cvaldess/LM20MeshNode/fab/pcbway/gerber/nrflm20-meshnode-drill_report.txt

Drill report for nrflm20-meshnode.kicad_pcb
Created on 2026-11-12T16:53:03

Copper Layer Stackup:
    =============================================================
    L1 :  F.Cu                      front
    L2 :  In1.Cu                    in1
    L3 :  In2.Cu                    in2
    L4 :  B.Cu                      back

Drill file 'nrflm20-meshnode-PTH.drl' contains
    plated through holes:
    =============================================================
    T1  0.300mm  0.0118"  (169 holes))
    T2  0.300mm  0.0118"  (5 holes))
    T3  0.600mm  0.0236"  (4 holes)  (with 4 slots)
    T4  0.900mm  0.0354"  (8 holes))
    T5  1.000mm  0.0394"  (4 holes))

    Total plated holes count 190

Drill file 'nrflm20-meshnode-NPTH.drl' contains
    unplated through holes:
    =============================================================
    T1  0.650mm  0.0256"  (2 holes))
    T2  2.200mm  0.0866"  (4 holes))

    Total unplated holes count 6
