cvaldess/LM20MeshNode/fab/pcbway/nrflm20-meshnode-BOM-PCBWay.csv

Designator | Qty | Manufacturer | Mfg Part # | Description/Value | Package/Footprint | LCSC Part #
BZ501 | 1 | Huayu | HYG-5020A | HYG-5020A | easyeda2kicad:BUZ-SMD_3P-L5.0-W5.0-P3.50-BL | C7544810
C101,C102,C204,C502 | 4 | Samsung | CL05A105KA5NQNC | 1u 25V | Capacitor_SMD:C_0402_1005Metric | C52923
C103,C104,C105,C107,C108,C201,C202,C401 | 8 | Generic |  | 10uF 20% 10V X7R 0603 | Capacitor_SMD:C_0603_1608Metric
C106 | 1 | Samsung | CL10A225KO8NNNC | 2u2 16V | Capacitor_SMD:C_0603_1608Metric | C23630
C110,C111,C203,C302,C402,C403,C501,C503,C504 | 9 | Samsung | CL05B104KO5NNNC | 100n | Capacitor_SMD:C_0402_1005Metric | C1525
C301 | 1 | Generic |  | 22uF 20% 10V X7R 0603 | Capacitor_SMD:C_0603_1608Metric
C404 | 1 | Samsung | CL05C560JB5NNNC | 56p C0G | Capacitor_SMD:C_0402_1005Metric | C84707
D101 | 1 | onsemi | ESD5Z6.0T1G | ESD5Z6.0T1G | easyeda2kicad:SOD-523F_L1.2-W0.8-LS1.7-RD | C82323
D102 | 1 | XINGLIGHT | XL-1608UBC-06A | Blue LED | LED_SMD:LED_0603_1608Metric | C7371904
D103,D501 | 2 | XINGLIGHT | XL-1608UGC-06A | Green LED | LED_SMD:LED_0603_1608Metric | C7371903
D502 | 1 | JSMSEMI | 1N4148W | 1N4148W | Diode_SMD:D_SOD-123 | C917030
DS501 | 1 | HS | HS91L02W2C01 | HS91L02W2C01 | easyeda2kicad:OLED-TH_L38.0-W12.0_HS91L02W2C01 | C5248081
FB201 | 1 | Generic |  | 0R 0603 jumper | Resistor_SMD:R_0603_1608Metric
J101 | 1 | Kinghelm | KH-TYPE-C-16P | KH-TYPE-C-16P | easyeda2kicad:USB-C-SMD_KH-TYPE-C-16P | C709357
J102 | 1 | JST | S2B-PH-SM4-TB(LF)(SN) | S2B-PH-SM4-TB | Connector_JST:JST_PH_S2B-PH-SM4-TB_1x02-1MP_P2.00mm_Horizontal | C295747
J201 | 1 | HANXIA | HX PZ1.27-2x5P TP | SWD 2x5 1.27 | Connector_PinHeader_1.27mm:PinHeader_2x05_P1.27mm_Vertical_SMD | C41376037
J301 | 1 | BAT WIRELESS | BWU.FL-IPEX1 | U.FL LoRa | easyeda2kicad:IPEX-SMD_BWIPX-1-001E | C5137195
J401 | 1 | BAT WIRELESS | BWU.FL-IPEX1 | U.FL GNSS | easyeda2kicad:IPEX-SMD_BWIPX-1-001E | C5137195
J501 | 1 | BOOMELE | 1.0T-4P | Qwiic 1.0T-4P | meshnode:BOOMELE_1.0T-4P_1x04-1MP_P1.00mm_Horizontal | C970137
L101,L102 | 2 | APV | APH201610C2R2MP01 | 2u2 | Inductor_SMD:L_Changjiang_FTC201610S | C42455301
L401 | 1 | Murata | LQG15HS82NJ02D | 82nH (active GNSS antenna bias) | Inductor_SMD:L_0402_1005Metric | C98002
Q501 | 1 | HT (Jin Yu) | BSS138 | BSS138 | Package_TO_SOT_SMD:SOT-23 | C27140738
R101,R301,R304 | 3 | Yageo | RC0402FR-070RL | 0R | Resistor_SMD:R_0402_1005Metric | C106231
R102 | 1 | Yageo | RC0402JR-07330KL | 330k 5% | Resistor_SMD:R_0402_1005Metric | C137882
R103,R104 | 2 | Yageo | RC0402FR-071ML | 1M | Resistor_SMD:R_0402_1005Metric | C138033
R303,R505 | 2 | Yageo | RC0402FR-07100KL | 100k | Resistor_SMD:R_0402_1005Metric | C60491
R401,R402,R403 | 3 | UNI-ROYAL | 0402WGF1001TCE | 1k | Resistor_SMD:R_0402_1005Metric | C11702
R501,R502 | 2 | Yageo | RC0402FR-074K7L | 4k7 | Resistor_SMD:R_0402_1005Metric | C105871
R503 | 1 | UNI-ROYAL | 0402WGF4700TCE | 470R | Resistor_SMD:R_0402_1005Metric | C25117
R504 | 1 | UNI-ROYAL | 0402WGF2200TCE | 220R | Resistor_SMD:R_0402_1005Metric | C25091
R506,R507 | 2 | Generic |  | 10R 5% 0603 | Resistor_SMD:R_0603_1608Metric
RT101 | 1 | Murata | NCP15XH103F0SRC | 10k B3380 | Resistor_SMD:R_0402_1005Metric | C91636
SW101,SW501,SW502,SW503 | 4 | Hanxia | HX TS35CA 160gf | HX TS35CA 160gf | easyeda2kicad:KEY-SMD_HX-TS35CA-250GF | C25168837
U101 | 1 | Nordic Semiconductor | nPM1300-QEAA | nPM1300-QEAA | meshnode:nPM1300-QFN32-EP3.5 | C7501206
U102 | 1 | DOWO | TPD4E05U06DQAR | TPD4E05U06DQAR | easyeda2kicad:DFN2510-10_L2.5-W1.0-P0.50-BL | C22390021
U201 | 1 | Minew | ME54BS13 (nRF54LM20A) | ME54BS13 | meshnode:ME54BS13
U301 | 1 | Ebyte | E22-900MM22S | E22-900MM22S | meshnode:E22-xxxMM22S
U401 | 1 | Ebyte | E108-GN04S | E108-GN04S | meshnode:E108-GN04S
U501 | 1 | Nyfea | SHT41-P-NF | SHT41-P-NF | easyeda2kicad:DFN-4_L1.5-W1.5-SHT41-AD1B-R2 | C55108905
U502 | 1 | STMicroelectronics | LSM6DS3TR-C | LSM6DS3TR-C | easyeda2kicad:LGA-14_L3.0-W2.5-P0.50-TL | C967633
