cvaldess/LM20MeshNode/nrflm20-meshnode.kicad_pcb

## KiCad design nrflm20-meshnode.kicad_pcb (2026-11-13)

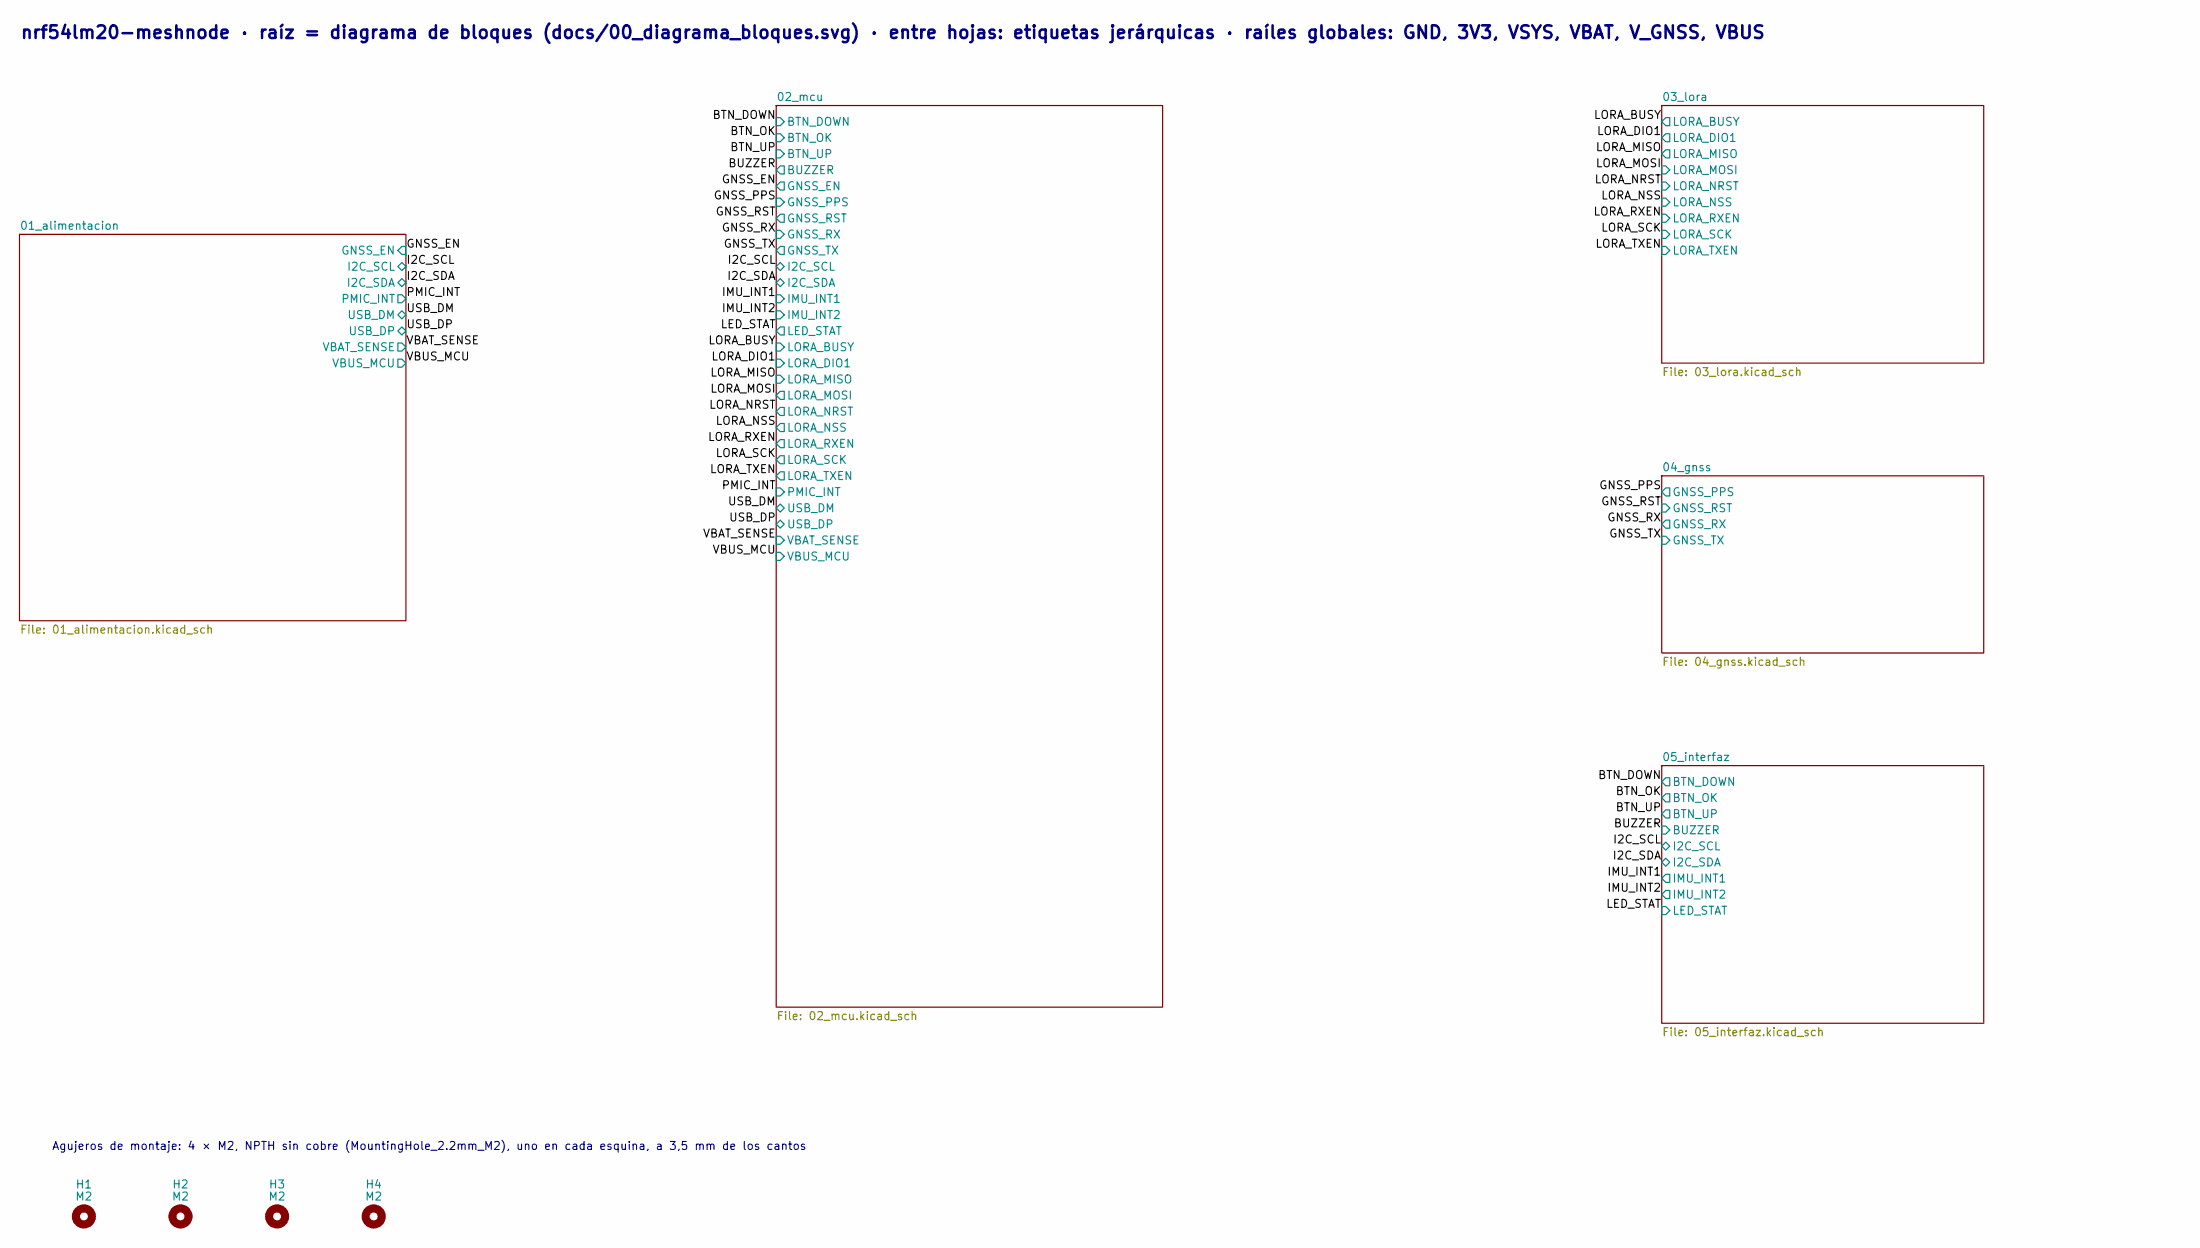
[picture p4: schematic nrflm20-meshnode.kicad_sch, nRF54LM20-MeshNode]

Parts:
H1, H2, H3, H4: M2; MountingHole_2.2mm_M2

Notes on the sheet:
nrf54lm20-meshnode · raíz = diagrama de bloques (docs/00_diagrama_bloques.svg) · entre hojas: etiquetas jerárquicas · raíles globales: GND, 3V3, VSYS, VBAT, V_GNSS, VBUS
Agujeros de montaje: 4 × M2, NPTH sin cobre (MountingHole_2.2mm_M2), uno en cada esquina, a 3,5 mm de los cantos

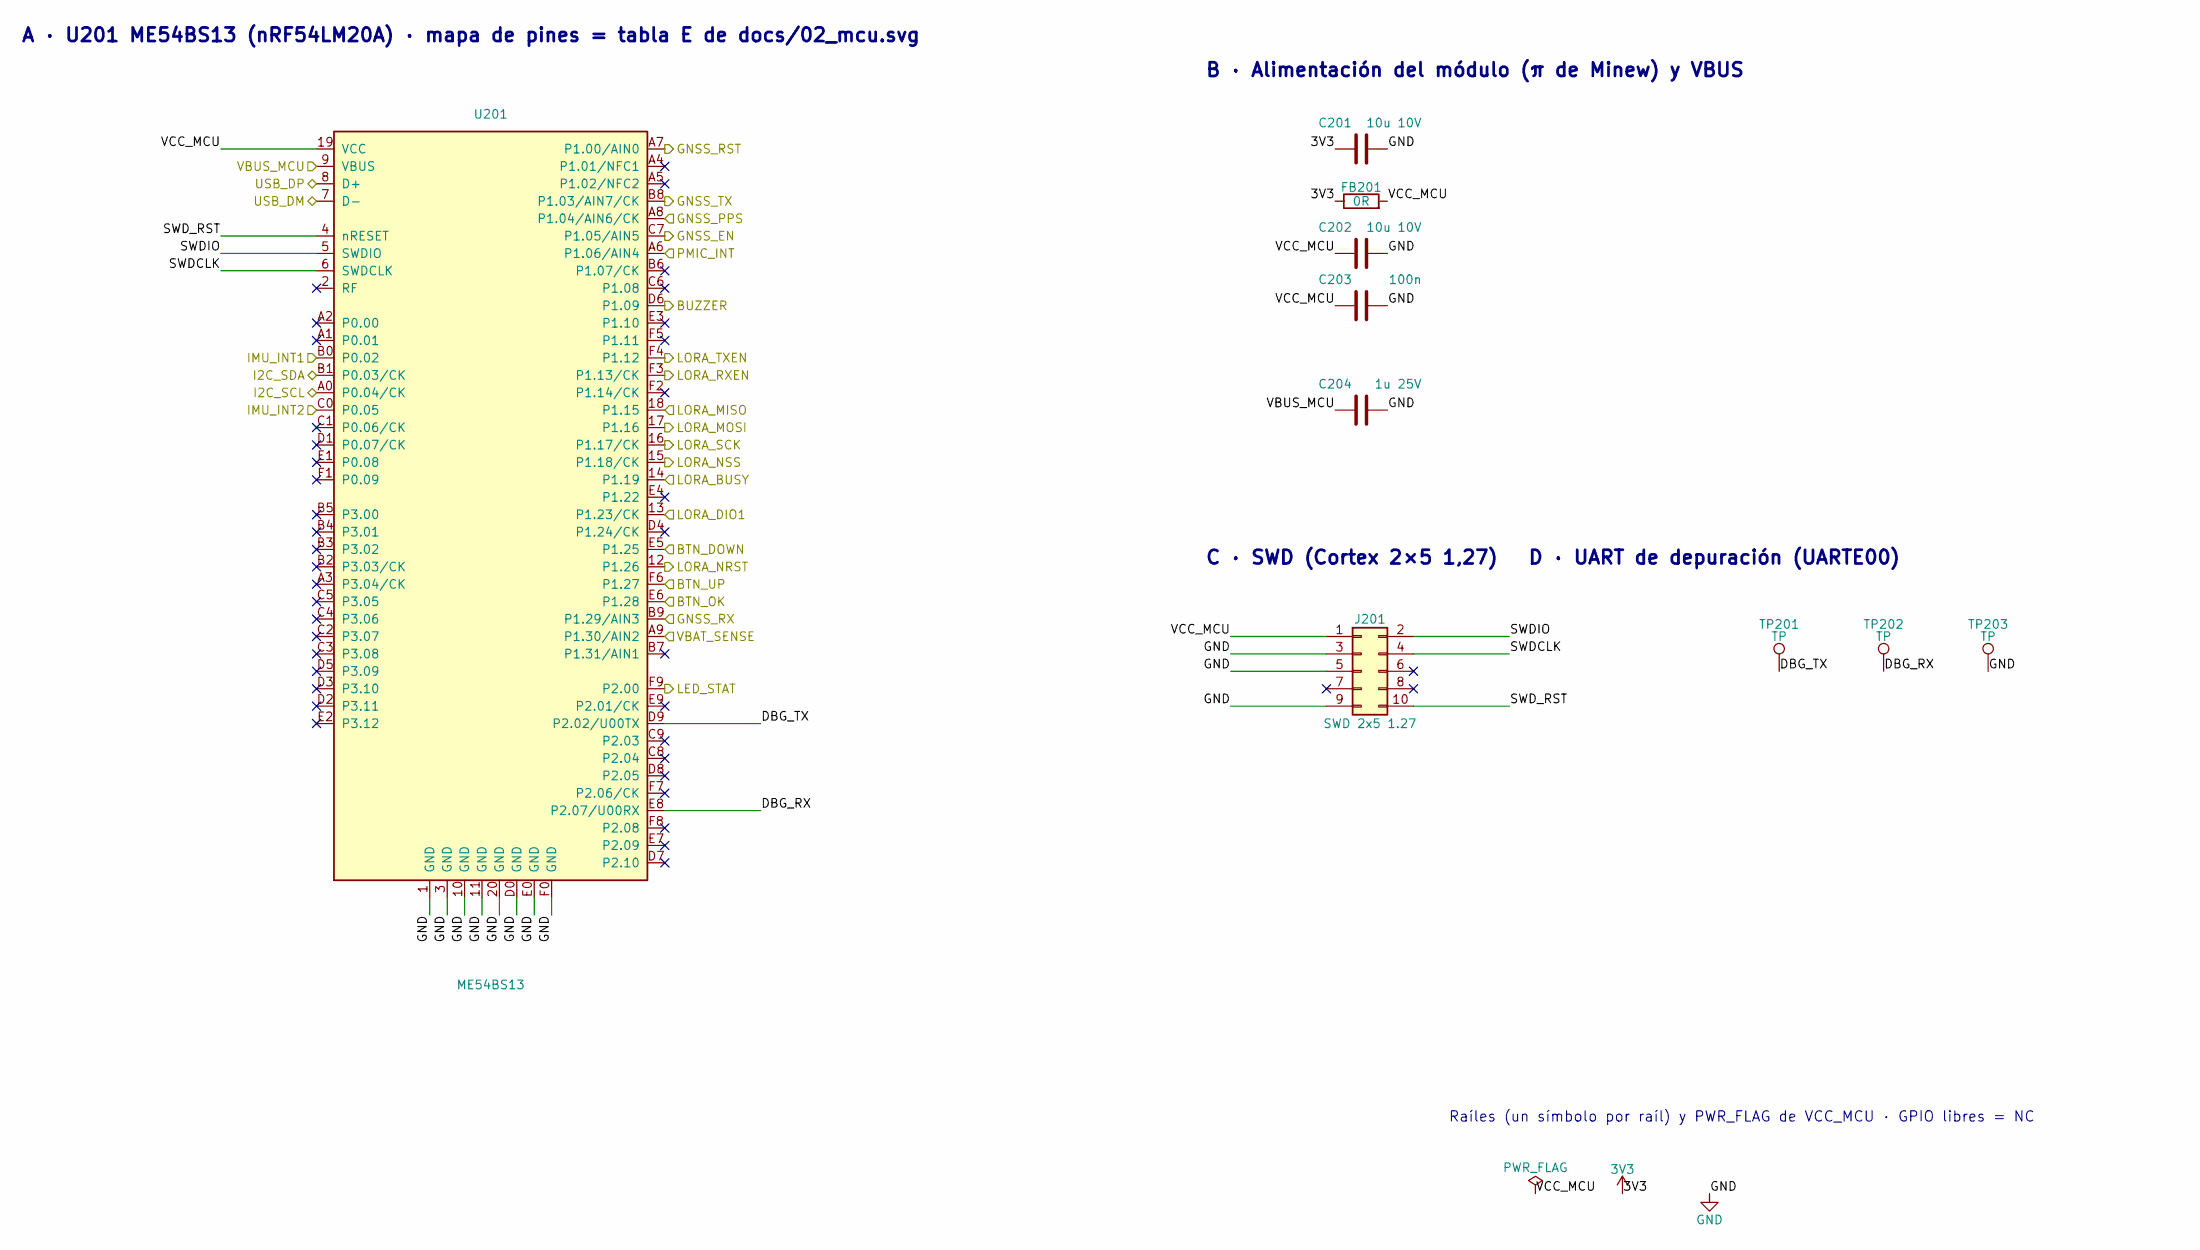
[picture p5: schematic 02_mcu.kicad_sch, nRF54LM20-MeshNode]

Parts:
C201, C202: 10u 10V; C_0603_1608Metric
C203: 100n; C_0402_1005Metric; MPN CL05B104KO5NNNC; LCSC Part C1525
C204: 1u 25V; C_0402_1005Metric; MPN CL05A105KA5NQNC; LCSC Part C52923
FB201: 0R; R_0603_1608Metric
J201: SWD 2x5 1.27; PinHeader_2x05_P1.27mm_Vertical_SMD; MPN HX PZ1.27-2x5P TP; LCSC Part C41376037
TP201, TP202, TP203: TP; TestPoint_Pad_D1.0mm
U201: ME54BS13; MPN ME54BS13 (nRF54LM20A)

Connections:
3V3: C201.1, FB201.1; also elsewhere on the board
/02_mcu/DBG_RX: TP202.1 (1_1), U201.E8 (P2.07/U00RX)
/02_mcu/DBG_TX: TP201.1 (1_1), U201.D9 (P2.02/U00TX)
/02_mcu/SWDCLK: J201.4, U201.6 (SWDCLK)
/02_mcu/SWDIO: J201.2, U201.5 (SWDIO)
/02_mcu/SWD_RST: J201.10, U201.4 (nRESET)
/02_mcu/VCC_MCU: C202.1, C203.1, FB201.2, J201.1, U201.19 (VCC)
/BTN_DOWN: U201.E5 (P1.25); also elsewhere on the board
/BTN_OK: U201.E6 (P1.28); also elsewhere on the board
/BTN_UP: U201.F6 (P1.27); also elsewhere on the board
/BUZZER: U201.D6 (P1.09); also elsewhere on the board
/GNSS_EN: U201.C7 (P1.05/AIN5); also elsewhere on the board
/GNSS_PPS: U201.A8 (P1.04/AIN6/CK); also elsewhere on the board
/GNSS_RST: U201.A7 (P1.00/AIN0); also elsewhere on the board
/GNSS_RX: U201.B9 (P1.29/AIN3); also elsewhere on the board
/GNSS_TX: U201.B8 (P1.03/AIN7/CK); also elsewhere on the board
/I2C_SCL: U201.A0 (P0.04/CK); also elsewhere on the board
/I2C_SDA: U201.B1 (P0.03/CK); also elsewhere on the board
/IMU_INT1: U201.B0 (P0.02); also elsewhere on the board
/IMU_INT2: U201.C0 (P0.05); also elsewhere on the board
/LED_STAT: U201.F9 (P2.00); also elsewhere on the board
/LORA_BUSY: U201.14 (P1.19); also elsewhere on the board
/LORA_DIO1: U201.13 (P1.23/CK); also elsewhere on the board
/LORA_MISO: U201.18 (P1.15); also elsewhere on the board
/LORA_MOSI: U201.17 (P1.16); also elsewhere on the board
/LORA_NRST: U201.12 (P1.26); also elsewhere on the board
/LORA_NSS: U201.15 (P1.18/CK); also elsewhere on the board
/LORA_RXEN: U201.F3 (P1.13/CK); also elsewhere on the board
/LORA_SCK: U201.16 (P1.17/CK); also elsewhere on the board
/LORA_TXEN: U201.F4 (P1.12); also elsewhere on the board
/PMIC_INT: U201.A6 (P1.06/AIN4); also elsewhere on the board
/USB_DM: U201.7 (D-); also elsewhere on the board
/USB_DP: U201.8 (D+); also elsewhere on the board
/VBAT_SENSE: U201.A9 (P1.30/AIN2); also elsewhere on the board
/VBUS_MCU: C204.1, U201.9 (VBUS); also elsewhere on the board
GND: C201.2, C202.2, C203.2, C204.2, J201.3, J201.5, J201.9, TP203.1 (1_1), U201.1 (GND), U201.3 (GND), U201.10 (GND), U201.11 (GND), U201.20 (GND), U201.D0 (GND), U201.E0 (GND), U201.F0 (GND); also elsewhere on the board

Notes on the sheet:
B · Alimentación del módulo (π de Minew) y VBUS
A · U201 ME54BS13 (nRF54LM20A) · mapa de pines = tabla E de docs/02_mcu.svg
C · SWD (Cortex 2×5 1,27) D · UART de depuración (UARTE00)
Raíles (un símbolo por raíl) y PWR_FLAG de VCC_MCU · GPIO libres = NC

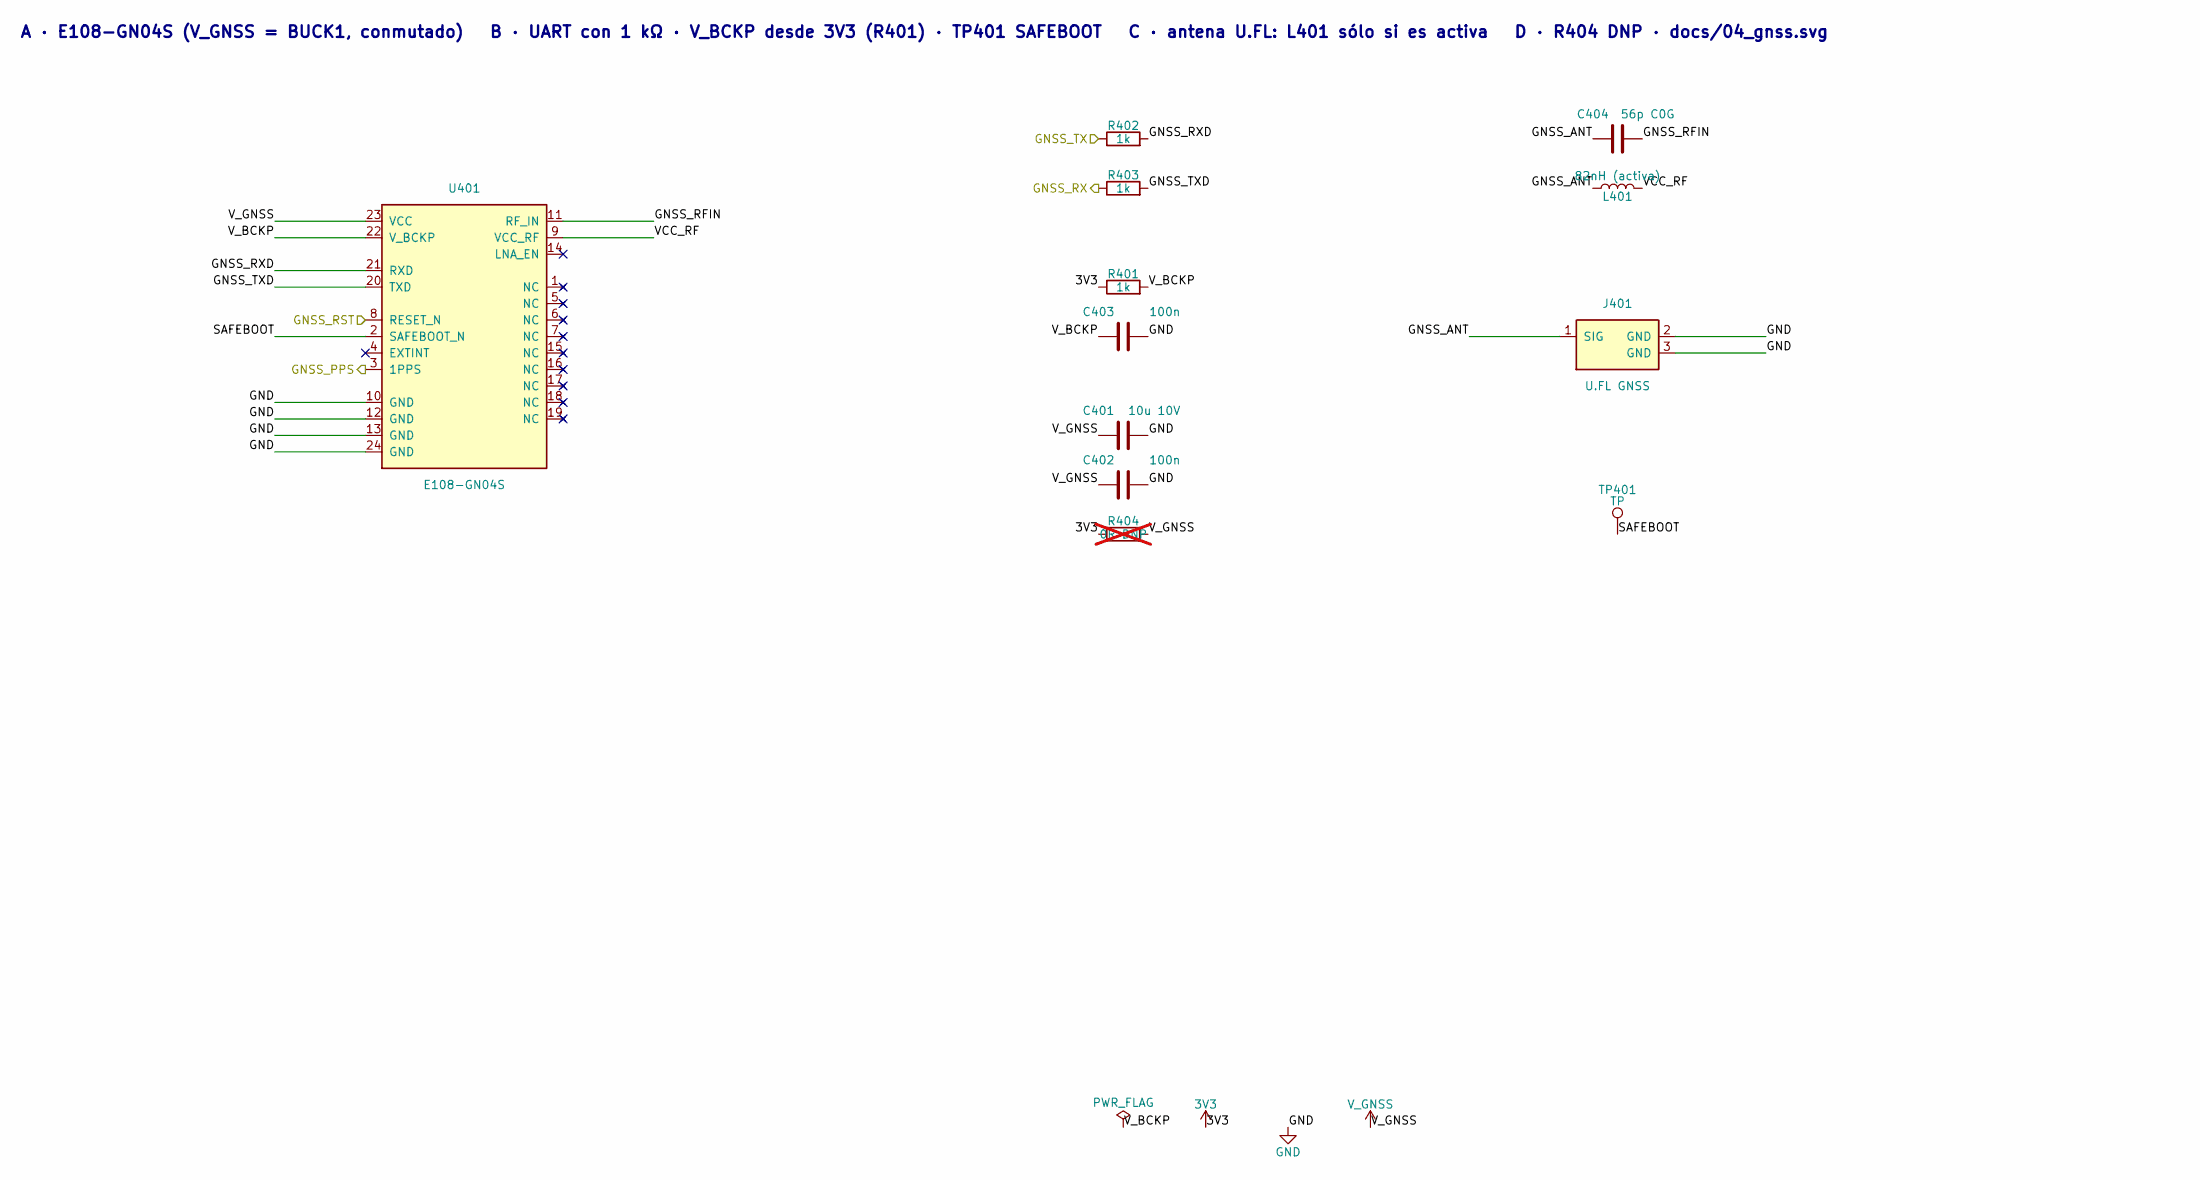
[picture p6: schematic 04_gnss.kicad_sch, nRF54LM20-MeshNode]

Parts:
C401: 10u 10V; C_0603_1608Metric
C402, C403: 100n; C_0402_1005Metric; MPN CL05B104KO5NNNC; LCSC Part C1525
C404: 56p C0G; C_0402_1005Metric; MPN CL05C560JB5NNNC; LCSC Part C84707
J401: U.FL GNSS; IPEX-SMD_BWIPX-1-001E; MPN BWU.FL-IPEX1; LCSC Part C5137195
L401: 82nH (activa); L_0402_1005Metric; MPN LQG15HS82NJ02D; LCSC Part C98002
R401, R402, R403: 1k; R_0402_1005Metric; MPN 0402WGF1001TCE; LCSC Part C11702
R404: 0R DNP; R_0402_1005Metric; MPN RC0402FR-070RL; LCSC Part C106231; not fitted
TP401: TP; TestPoint_Pad_D1.0mm
U401: E108-GN04S; MPN E108-GN04S

Connections:
3V3: R401.1, R404.1; also elsewhere on the board
/04_gnss/GNSS_ANT: C404.1, J401.1 (SIG), L401.1
/04_gnss/GNSS_RFIN: C404.2, U401.11 (RF_IN)
/04_gnss/GNSS_RXD: R402.2, U401.21 (RXD)
/04_gnss/GNSS_TXD: R403.2, U401.20 (TXD)
/04_gnss/SAFEBOOT: TP401.1 (1_1), U401.2 (SAFEBOOT_N)
/04_gnss/VCC_RF: L401.2, U401.9 (VCC_RF)
/04_gnss/V_BCKP: C403.1, R401.2, U401.22 (V_BCKP)
/GNSS_PPS: U401.3 (1PPS); also elsewhere on the board
/GNSS_RST: U401.8 (RESET_N); also elsewhere on the board
/GNSS_RX: R403.1; also elsewhere on the board
/GNSS_TX: R402.1; also elsewhere on the board
GND: C401.2, C402.2, C403.2, J401.2 (GND), J401.3 (GND), U401.10 (GND), U401.12 (GND), U401.13 (GND), U401.24 (GND); also elsewhere on the board
V_GNSS: C401.1, C402.1, R404.2, U401.23 (VCC); also elsewhere on the board

Notes on the sheet:
A · E108-GN04S (V_GNSS = BUCK1, conmutado) B · UART con 1 kΩ · V_BCKP desde 3V3 (R401) · TP401 SAFEBOOT C · antena U.FL: L401 sólo si es activa D · R404 DNP · docs/04_gnss.svg

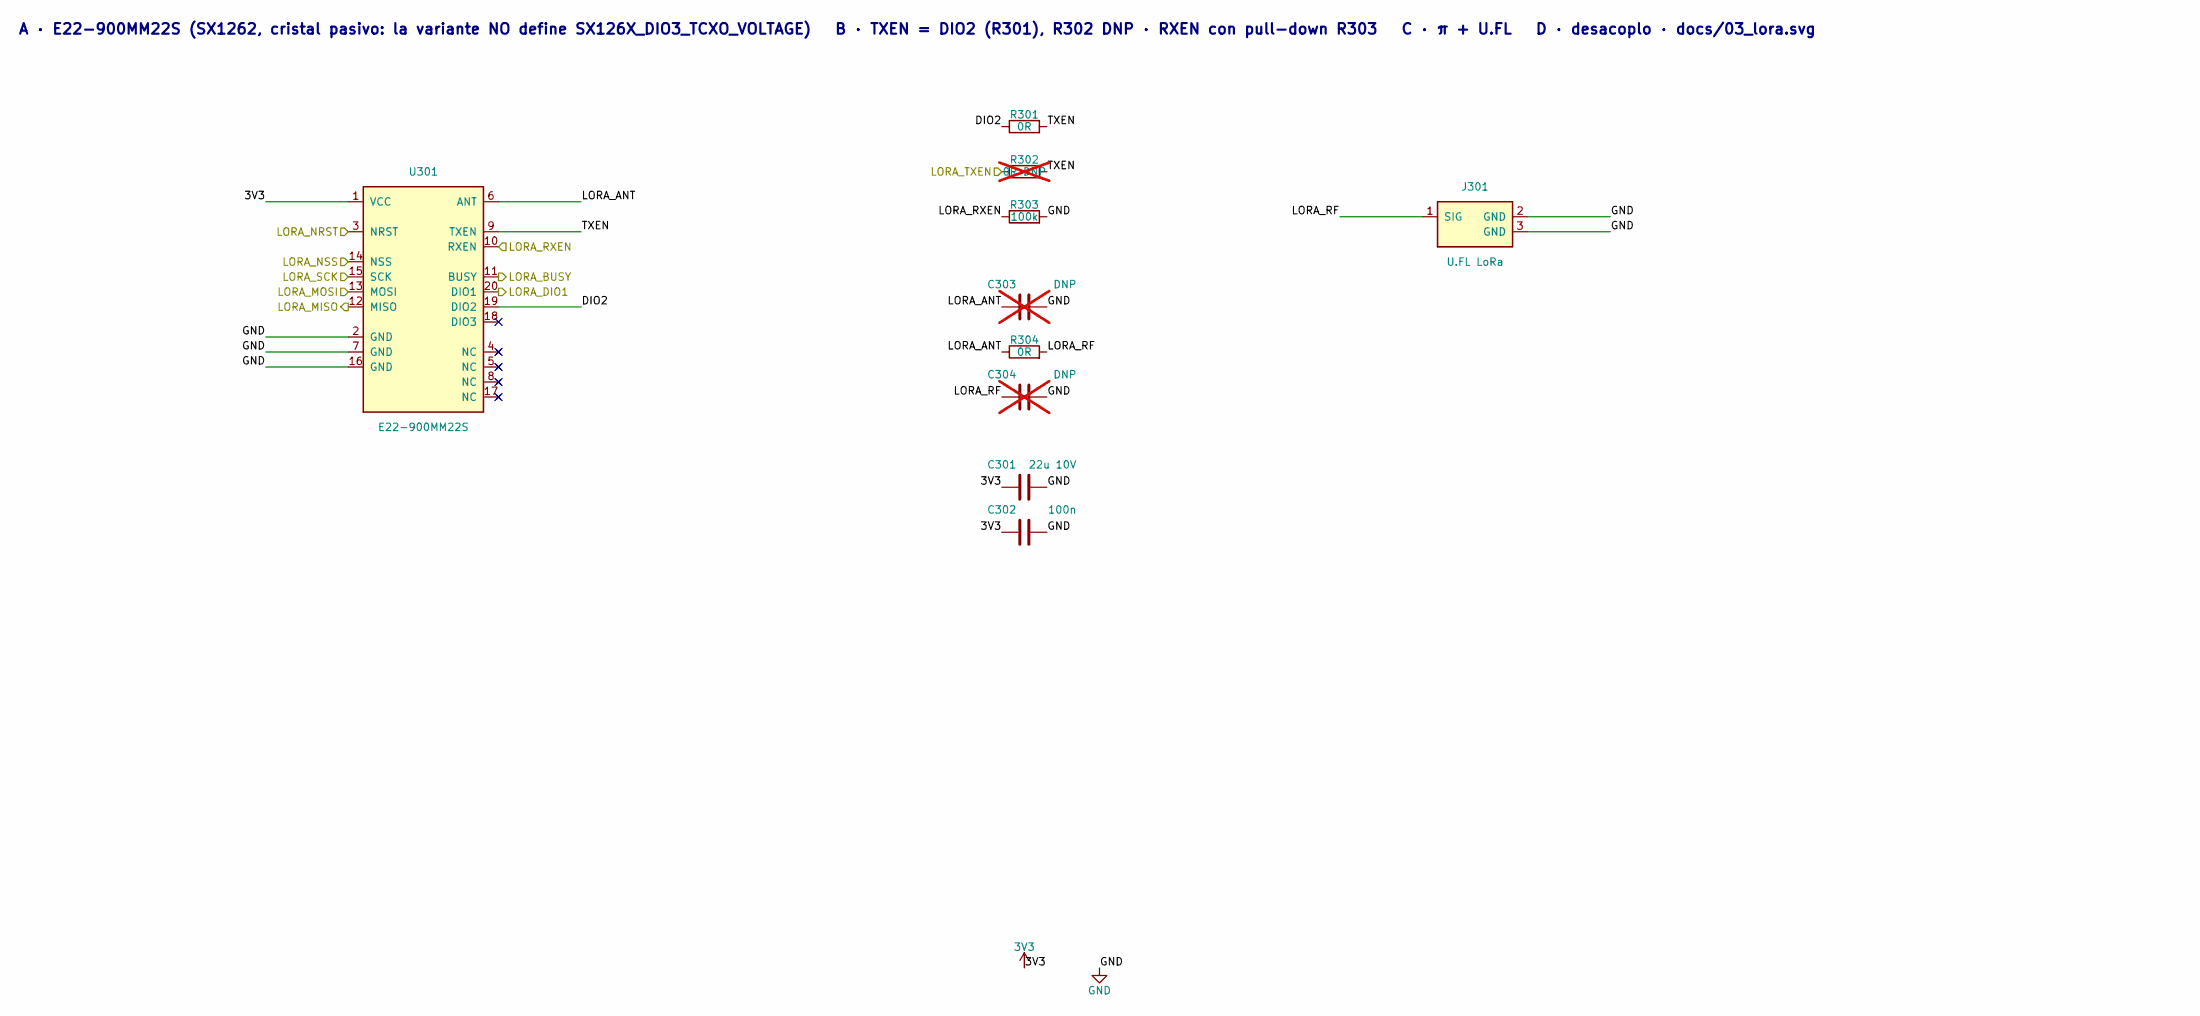
[picture p7: schematic 03_lora.kicad_sch, nRF54LM20-MeshNode]

Parts:
C301: 22u 10V; C_0603_1608Metric
C302: 100n; C_0402_1005Metric; MPN CL05B104KO5NNNC; LCSC Part C1525
C303, C304: DNP; C_0402_1005Metric; not fitted
J301: U.FL LoRa; IPEX-SMD_BWIPX-1-001E; MPN BWU.FL-IPEX1; LCSC Part C5137195
R301, R304: 0R; R_0402_1005Metric; MPN RC0402FR-070RL; LCSC Part C106231
R302: 0R DNP; R_0402_1005Metric; MPN RC0402FR-070RL; LCSC Part C106231; not fitted
R303: 100k; R_0402_1005Metric; MPN RC0402FR-07100KL; LCSC Part C60491
U301: E22-900MM22S; E22-xxxMM22S; MPN E22-900MM22S

Connections:
3V3: C301.1, C302.1, U301.1 (VCC); also elsewhere on the board
/03_lora/DIO2: R301.1, U301.19 (DIO2)
/03_lora/LORA_ANT: C303.1, R304.1, U301.6 (ANT)
/03_lora/LORA_RF: C304.1, J301.1 (SIG), R304.2
/03_lora/TXEN: R301.2, R302.2, U301.9 (TXEN)
/LORA_BUSY: U301.11 (BUSY); also elsewhere on the board
/LORA_DIO1: U301.20 (DIO1); also elsewhere on the board
/LORA_MISO: U301.12 (MISO); also elsewhere on the board
/LORA_MOSI: U301.13 (MOSI); also elsewhere on the board
/LORA_NRST: U301.3 (NRST); also elsewhere on the board
/LORA_NSS: U301.14 (NSS); also elsewhere on the board
/LORA_RXEN: R303.1, U301.10 (RXEN); also elsewhere on the board
/LORA_SCK: U301.15 (SCK); also elsewhere on the board
/LORA_TXEN: R302.1; also elsewhere on the board
GND: C301.2, C302.2, C303.2, C304.2, J301.2 (GND), J301.3 (GND), R303.2, U301.2 (GND), U301.7 (GND), U301.16 (GND); also elsewhere on the board

Notes on the sheet:
A · E22-900MM22S (SX1262, cristal pasivo: la variante NO define SX126X_DIO3_TCXO_VOLTAGE) B · TXEN = DIO2 (R301), R302 DNP · RXEN con pull-down R303 C · π + U.FL D · desacoplo · docs/03_lora.svg

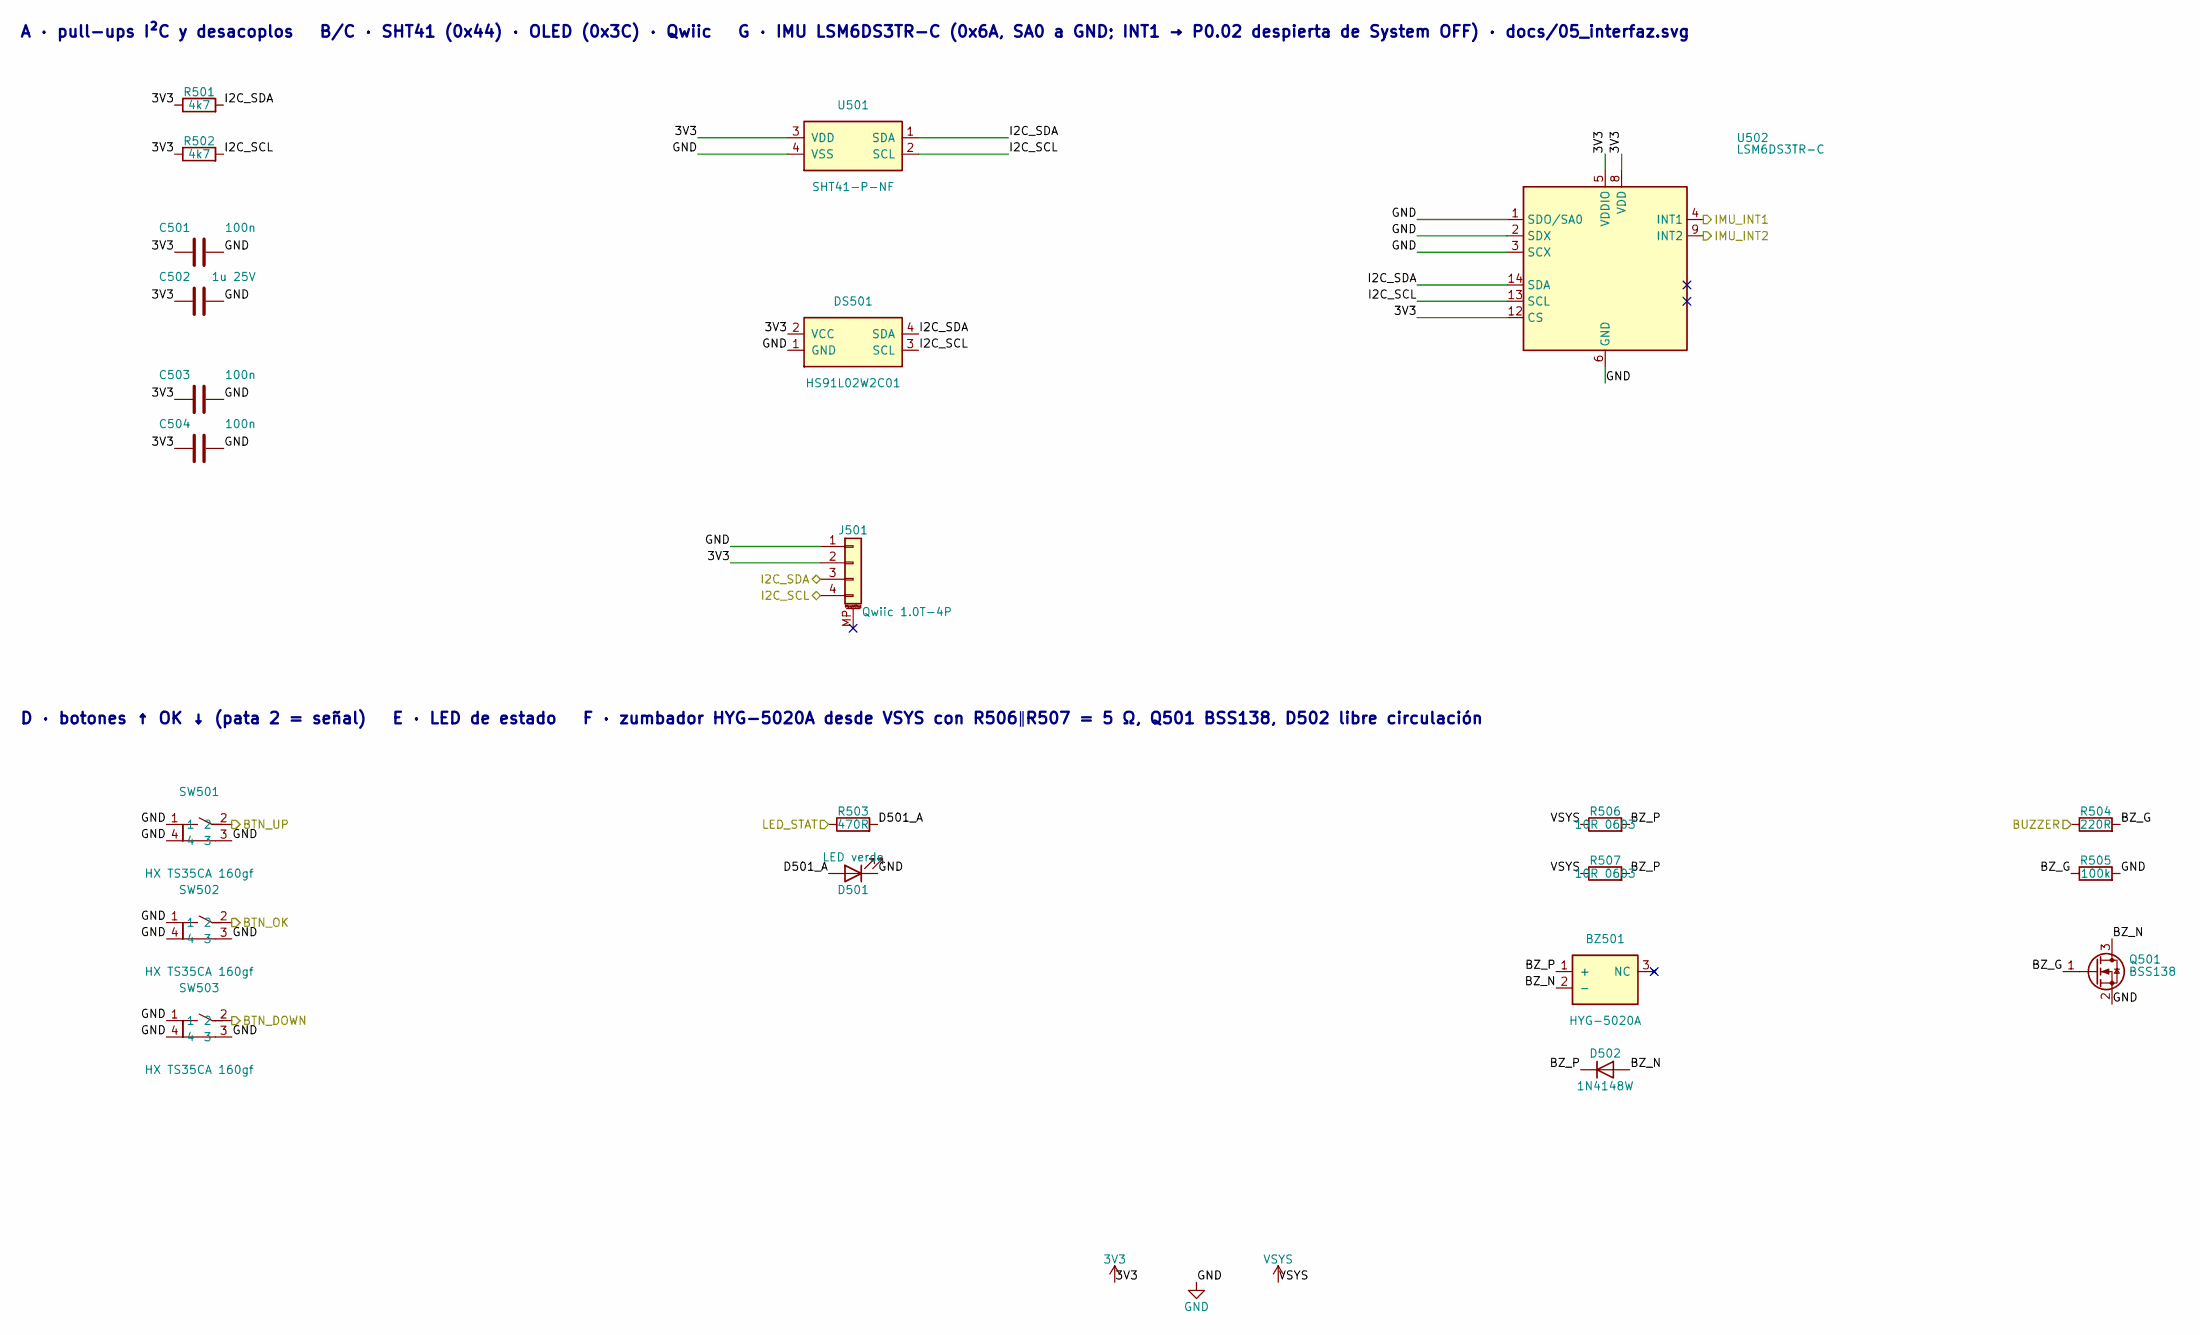
[picture p8: schematic 05_interfaz.kicad_sch, nRF54LM20-MeshNode]

Parts:
BZ501: HYG-5020A; BUZ-SMD_3P-L5.0-W5.0-P3.50-BL; MPN HYG-5020A; LCSC Part C7544810
C501, C503, C504: 100n; C_0402_1005Metric; MPN CL05B104KO5NNNC; LCSC Part C1525
C502: 1u 25V; C_0402_1005Metric; MPN CL05A105KA5NQNC; LCSC Part C52923
D501: LED verde; LED_0603_1608Metric; MPN XL-1608UGC-06A; LCSC Part C7371903
D502: 1N4148W; D_SOD-123; MPN 1N4148W; LCSC Part C917030
DS501: HS91L02W2C01; OLED-TH_L38.0-W12.0_HS91L02W2C01; MPN HS91L02W2C01; LCSC Part C5248081
J501: Qwiic 1.0T-4P; BOOMELE_1.0T-4P_1x04-1MP_P1.00mm_Horizontal; MPN 1.0T-4P; LCSC Part C970137
Q501: BSS138; SOT-23; MPN BSS138; LCSC Part C27140738
R501, R502: 4k7; R_0402_1005Metric; MPN RC0402FR-074K7L; LCSC Part C105871
R503: 470R; R_0402_1005Metric; MPN 0402WGF4700TCE; LCSC Part C25117
R504: 220R; R_0402_1005Metric; MPN 0402WGF2200TCE; LCSC Part C25091
R505: 100k; R_0402_1005Metric; MPN RC0402FR-07100KL; LCSC Part C60491
R506, R507: 10R 0603; R_0603_1608Metric
SW501, SW502, SW503: HX TS35CA 160gf; KEY-SMD_HX-TS35CA-250GF; MPN HX TS35CA 160gf; LCSC Part C25168837
U501: SHT41-P-NF; DFN-4_L1.5-W1.5-SHT41-AD1B-R2; MPN SHT41-P-NF; LCSC Part C55108905
U502: LSM6DS3TR-C; LGA-14_L3.0-W2.5-P0.50-TL; MPN LSM6DS3TR-C; LCSC Part C967633

Connections:
3V3: C501.1, C502.1, C503.1, C504.1, DS501.2 (VCC), J501.2, R501.1, R502.1, U501.3 (VDD), U502.5 (VDDIO), U502.8 (VDD), U502.12 (CS); also elsewhere on the board
/05_interfaz/BZ_G: Q501.1 (G), R504.2, R505.1
/05_interfaz/BZ_N: BZ501.2 (-), D502.2 (A), Q501.3 (D)
/05_interfaz/BZ_P: BZ501.1 (+), D502.1 (K), R506.2, R507.2
/05_interfaz/D501_A: D501.2 (A), R503.2
/BTN_DOWN: SW503.2; also elsewhere on the board
/BTN_OK: SW502.2; also elsewhere on the board
/BTN_UP: SW501.2; also elsewhere on the board
/BUZZER: R504.1; also elsewhere on the board
/I2C_SCL: DS501.3 (SCL), J501.4, R502.2, U501.2 (SCL), U502.13 (SCL); also elsewhere on the board
/I2C_SDA: DS501.4 (SDA), J501.3, R501.2, U501.1 (SDA), U502.14 (SDA); also elsewhere on the board
/IMU_INT1: U502.4 (INT1); also elsewhere on the board
/IMU_INT2: U502.9 (INT2); also elsewhere on the board
/LED_STAT: R503.1; also elsewhere on the board
GND: C501.2, C502.2, C503.2, C504.2, D501.1 (K), DS501.1 (GND), J501.1, Q501.2 (S), R505.2, SW501.1, SW501.3, SW501.4, SW502.1, SW502.3, SW502.4, SW503.1, SW503.3, SW503.4, U501.4 (VSS), U502.1 (SDO/SA0), U502.2 (SDX), U502.3 (SCX), U502.6 (GND), U502.7 (GND); also elsewhere on the board
VSYS: R506.1, R507.1; also elsewhere on the board

Notes on the sheet:
A · pull-ups I²C y desacoplos B/C · SHT41 (0x44) · OLED (0x3C) · Qwiic G · IMU LSM6DS3TR-C (0x6A, SA0 a GND; INT1 → P0.02 despierta de System OFF) · docs/05_interfaz.svg
D · botones ↑ OK ↓ (pata 2 = señal) E · LED de estado F · zumbador HYG-5020A desde VSYS con R506∥R507 = 5 Ω, Q501 BSS138, D502 libre circulación
