cvaldess/LM20MeshNode/nrflm20-meshnode.kicad_pcb

## KiCad design nrflm20-meshnode.kicad_pcb (continued)

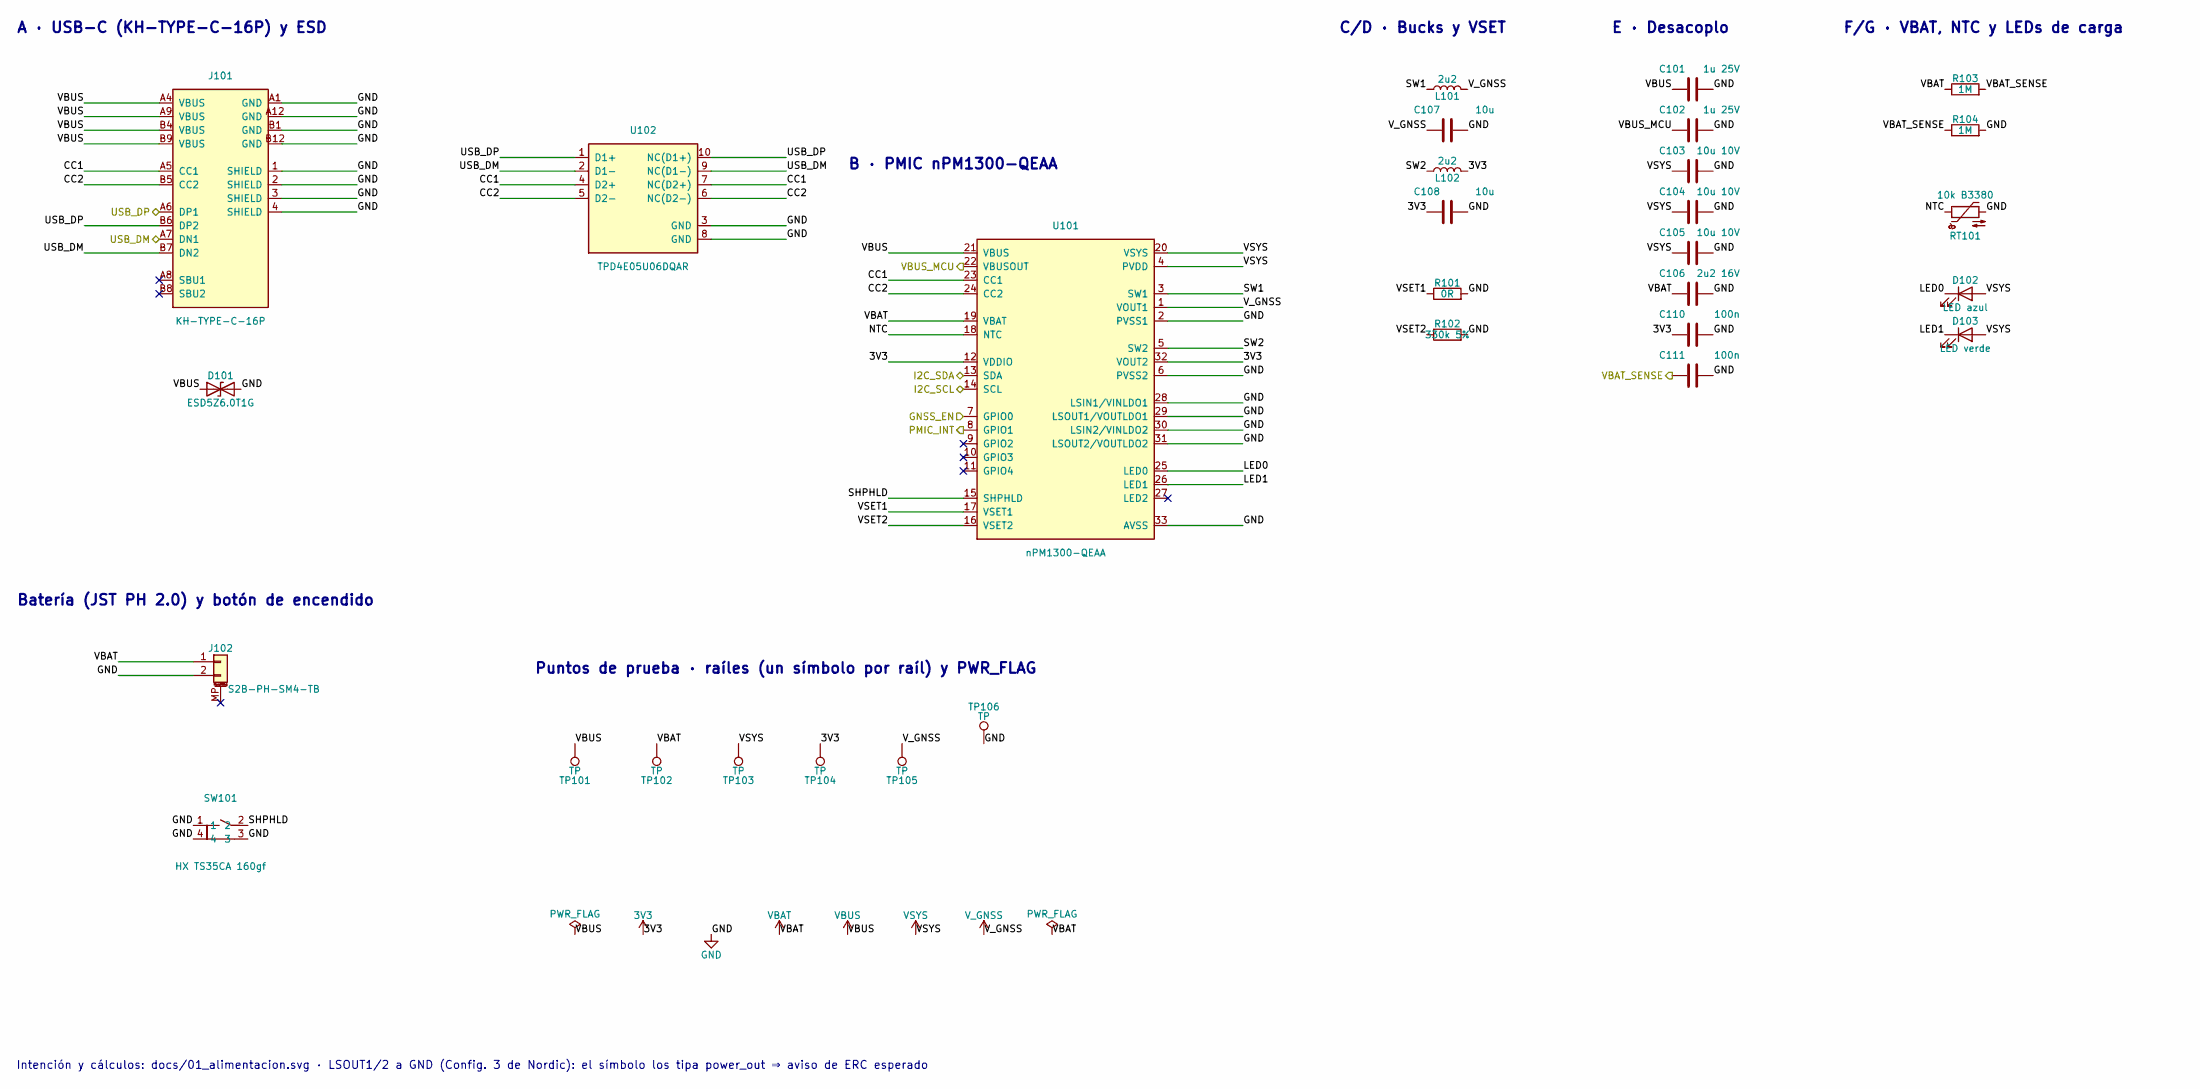
[picture p9: schematic 01_alimentacion.kicad_sch, nRF54LM20-MeshNode]

Parts:
C101, C102: 1u 25V; C_0402_1005Metric; MPN CL05A105KA5NQNC; LCSC Part C52923
C103, C104, C105: 10u 10V; C_0603_1608Metric
C106: 2u2 16V; C_0603_1608Metric; MPN CL10A225KO8NNNC; LCSC Part C23630
C107, C108: 10u; C_0603_1608Metric
C110, C111: 100n; C_0402_1005Metric; MPN CL05B104KO5NNNC; LCSC Part C1525
D101: ESD5Z6.0T1G; SOD-523F_L1.2-W0.8-LS1.7-RD; MPN ESD5Z6.0T1G; LCSC Part C82323
D102: LED azul; LED_0603_1608Metric; MPN XL-1608UBC-06A; LCSC Part C7371904
D103: LED verde; LED_0603_1608Metric; MPN XL-1608UGC-06A; LCSC Part C7371903
J101: KH-TYPE-C-16P; USB-C-SMD_KH-TYPE-C-16P; MPN KH-TYPE-C-16P; LCSC Part C709357
J102: S2B-PH-SM4-TB; JST_PH_S2B-PH-SM4-TB_1x02-1MP_P2.00mm_Horizontal; MPN S2B-PH-SM4-TB(LF)(SN); LCSC Part C295747
L101, L102: 2u2; L_Changjiang_FTC201610S; MPN APH201610C2R2MP01; LCSC Part C42455301
R101: 0R; R_0402_1005Metric; MPN RC0402FR-070RL; LCSC Part C106231
R102: 330k 5%; R_0402_1005Metric; MPN RC0402JR-07330KL; LCSC Part C137882
R103, R104: 1M; R_0402_1005Metric; MPN RC0402FR-071ML; LCSC Part C138033
RT101: 10k B3380; R_0402_1005Metric; MPN NCP15XH103F0SRC; LCSC Part C91636
SW101: HX TS35CA 160gf; KEY-SMD_HX-TS35CA-250GF; MPN HX TS35CA 160gf; LCSC Part C25168837
TP101, TP102, TP103, TP104, TP105, TP106: TP; TestPoint_Pad_D1.0mm
U101: nPM1300-QEAA; nPM1300-QFN32-EP3.5; MPN nPM1300-QEAA; LCSC Part C7501206
U102: TPD4E05U06DQAR; DFN2510-10_L2.5-W1.0-P0.50-BL; MPN TPD4E05U06DQAR; LCSC Part C22390021

Connections:
3V3: C108.1, C110.1, L102.2, TP104.1 (1_1), U101.12 (VDDIO), U101.32 (VOUT2); also elsewhere on the board
/01_alimentacion/CC1: J101.A5 (CC1), U101.23 (CC1), U102.4 (D2+), U102.7 (NC(D2+))
/01_alimentacion/CC2: J101.B5 (CC2), U101.24 (CC2), U102.5 (D2-), U102.6 (NC(D2-))
/01_alimentacion/LED0: D102.1 (K), U101.25 (LED0)
/01_alimentacion/LED1: D103.1 (K), U101.26 (LED1)
/01_alimentacion/NTC: RT101.1, U101.18 (NTC)
/01_alimentacion/SHPHLD: SW101.2, U101.15 (SHPHLD)
/01_alimentacion/SW1: L101.1, U101.3 (SW1)
/01_alimentacion/SW2: L102.1, U101.5 (SW2)
/01_alimentacion/VSET1: R101.1, U101.17 (VSET1)
/01_alimentacion/VSET2: R102.1, U101.16 (VSET2)
/GNSS_EN: U101.7 (GPIO0); also elsewhere on the board
/I2C_SCL: U101.14 (SCL); also elsewhere on the board
/I2C_SDA: U101.13 (SDA); also elsewhere on the board
/PMIC_INT: U101.8 (GPIO1); also elsewhere on the board
/USB_DM: J101.A7 (DN1), J101.B7 (DN2), U102.2 (D1-), U102.9 (NC(D1-)); also elsewhere on the board
/USB_DP: J101.A6 (DP1), J101.B6 (DP2), U102.1 (D1+), U102.10 (NC(D1+)); also elsewhere on the board
/VBAT_SENSE: C111.1, R103.2, R104.1; also elsewhere on the board
/VBUS_MCU: C102.1, U101.22 (VBUSOUT); also elsewhere on the board
GND: C101.2, C102.2, C103.2, C104.2, C105.2, C106.2, C107.2, C108.2, C110.2, C111.2, D101.2 (A2), J101.1 (SHIELD), J101.2 (SHIELD), J101.3 (SHIELD), J101.4 (SHIELD), J101.A1 (GND), J101.A12 (GND), J101.B1 (GND), J101.B12 (GND), J102.2, R101.2, R102.2, R104.2, RT101.2, SW101.1, SW101.3, SW101.4, TP106.1 (1_1), U101.2 (PVSS1), U101.6 (PVSS2), U101.28 (LSIN1/VINLDO1), U101.29 (LSOUT1/VOUTLDO1), U101.30 (LSIN2/VINLDO2), U101.31 (LSOUT2/VOUTLDO2), U101.33 (AVSS), U102.3 (GND), U102.8 (GND); also elsewhere on the board
VBAT: C106.1, J102.1, R103.1, TP102.1 (1_1), U101.19 (VBAT)
VBUS: C101.1, D101.1 (A1), J101.A4 (VBUS), J101.A9 (VBUS), J101.B4 (VBUS), J101.B9 (VBUS), TP101.1 (1_1), U101.21 (VBUS)
VSYS: C103.1, C104.1, C105.1, D102.2 (A), D103.2 (A), TP103.1 (1_1), U101.4 (PVDD), U101.20 (VSYS); also elsewhere on the board
V_GNSS: C107.1, L101.2, TP105.1 (1_1), U101.1 (VOUT1); also elsewhere on the board

Notes on the sheet:
B · PMIC nPM1300-QEAA
E · Desacoplo
F/G · VBAT, NTC y LEDs de carga
C/D · Bucks y VSET
Puntos de prueba · raíles (un símbolo por raíl) y PWR_FLAG
Batería (JST PH 2.0) y botón de encendido
A · USB-C (KH-TYPE-C-16P) y ESD
Intención y cálculos: docs/01_alimentacion.svg · LSOUT1/2 a GND (Config. 3 de Nordic): el símbolo los tipa power_out ⇒ aviso de ERC esperado

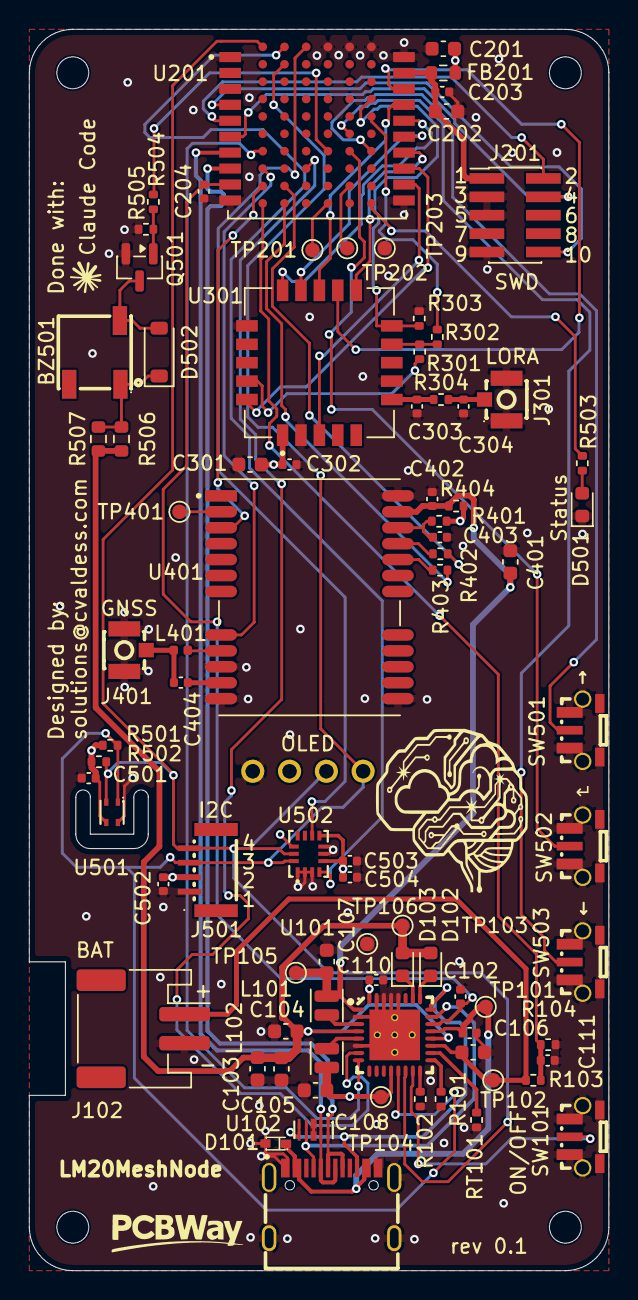
[picture p10: board nrflm20-meshnode.kicad_pcb from above]

Board: 4 copper layers, 40.0 x 85.7 mm, 89 parts (1 on the bottom side), 65 nets.
