cvaldess/LM20MeshNode/(commit log)

2026-11-12 LM20MeshNode rev 0.1: pocket Meshtastic node with nRF54LM20A
    KiCad 10 project for a battery-powered Meshtastic node: Minew ME54BS13
    (nRF54LM20A, BLE), Ebyte E22-900MM22S LoRa, Ebyte E108-GN04S GNSS and a
    Nordic nPM1300 PMIC with 1S LiPo charger. 0.91" OLED, three side buttons,
    buzzer, SHT41 and LSM6DS3TR-C sensors, Qwiic-style I2C connector.
    4 layers, 40 x 85.68 mm. Includes Gerber/drill zip and order notes for
    PCBWay, project libraries with 3D models, and the design scripts.
    [01_alimentacion.kicad_sch, 02_mcu.kicad_sch, 03_lora.kicad_sch, 04_gnss.kicad_sch, 05_interfaz.kicad_sch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]
2026-11-12 Add license, BOM and placement files; fix OLED SCL silkscreen
    - Back silkscreen: OLED pin 3 label "SLC" corrected to "SCL"; Gerber,
    drill, IPC-D-356 and zip regenerated (only B_Silkscreen changes).
    - BOM and centroid (CPL) for PCBWay: 40 lines / 71 parts, DNP parts,
    mounting holes and test points left out.
    - docs/gen/fab_pcbway.py and docs/gen/bom_cpl_pcbway.py regenerate the
    fabrication outputs from the saved board.
    - License: CERN-OHL-S v2.
    - Back 3D view updated; README: manufacturing files and license.
    [nrflm20-meshnode-BOM-PCBWay.csv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]
2026-11-12 Fix PCBWay image link in README
    Updated PCBWay image link in README.
2026-11-13 README: Meshtastic firmware variant under review
    The lm20meshnode variant is open as a draft: meshtastic/firmware#12354 (on top of the
    nRF54LM20-DK support in #12130), with the core variant (andyshinn/nRF54_Arduino#3) and the
    bootloader board (andyshinn/nRF54_Bootloader#3). Status line updated, and a new section on
    what the variant does on this board (nPM1300 setup, buttons, bootloader buttons, USB) and
    what is still untested.
2026-11-13 add leds info on B.cu
    [nrflm20-meshnode.kicad_pcb]
